arspauld/Ragnarok-2020/software/Flight Simulation/Descent Rate Equations.docx

A_c = 0.0123 m^2 , A_p =0.02 m^2 (1)

C_(D,c) =0.82, C_(D,p) =1.00 (2)

D=1/2C_D ρV^2 A (3)

V= √((2D)/(C_D ρA))=√((2mg)/(ρ(C_(D,c) A_c +C_(D,p) A_p ))) (4)

V= √((2*0.6 (kg)*9.805 (m/(s^2)))/(1.1117 ((kg)/(m^3))*(0.82*0.0123 (m^2 )+1.00*0.02 (m^2 ))))=18.76 m/s

A_c = 0.0123 m^2 , A_p =0.02 m^2 (1)

C_(D,c) =0.82, C_(D,p) =1.00 (2)

D=1/2C_D ρV^2 A (3)

V= √((2D)/(C_D ρA))=√((2mg)/(ρ(C_(D,c) A_c +C_(D,p) A_p ))) (4)

V= √((2*0.15 (kg)*9.805 (m/(s^2)))/(1.1117 ((kg)/(m^3))*(0.82*0.0123 (m^2 )+1.00*0.02 (m^2 ))))= 9.38 m/s

A_p =0.10 m^2 (1)

C_(D,p) =1.00 (2)

D=1/2C_D ρV^2 A (3)

V=√((2mg)/(C_(D,p) ρA_p)) (4)

V= √((2*0.45 (kg)*9.805 (m/(s^2)))/(1.00*1.1117 ((kg)/(m^3))*0.10 (m^2 )))=8.91 m/s

L=1/2C_L ρV^2 S (1)

C_L = (2L)/(ρV^2 S)= (2mg)/(ρV^2 S) (2)

C_D =C_(D,0) +(C_L^2)/(πeAR) (3)

V_z =-(‖V‖)/(√(((C_L)/(C_D))^2 +1)) (4)
