arspauld/Ragnarok-2020/software/Flight Simulation/glide.png

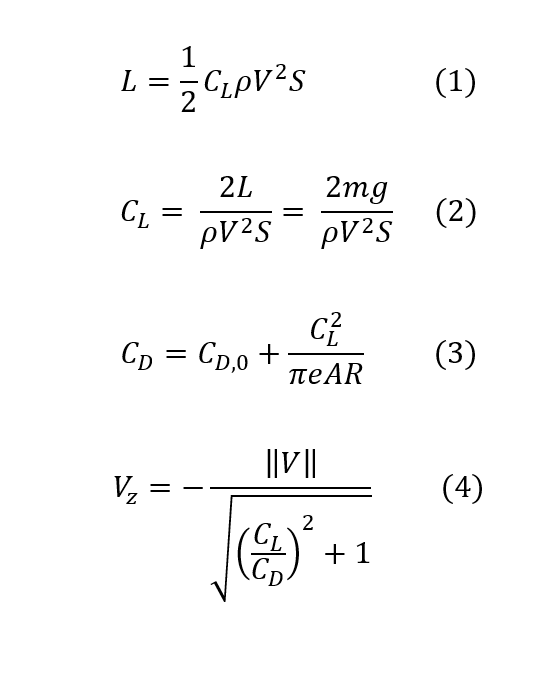
software/Flight Simulation/glide.png
