arspauld/Ragnarok-2020/software/Flight Simulation/glider.png

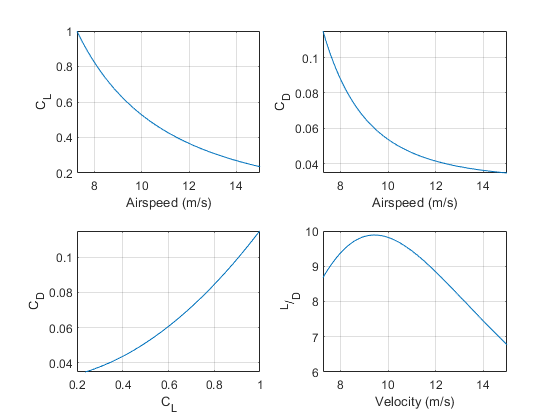
software/Flight Simulation/glider.png
