arspauld/Ragnarok-2020/software/Flight Simulation/postglide.png

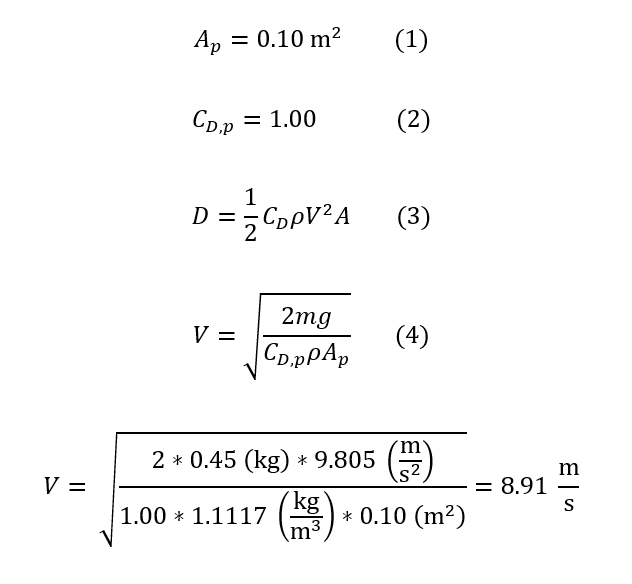
software/Flight Simulation/postglide.png
