arspauld/Ragnarok-2020/software/Flight Simulation/postrelease.png

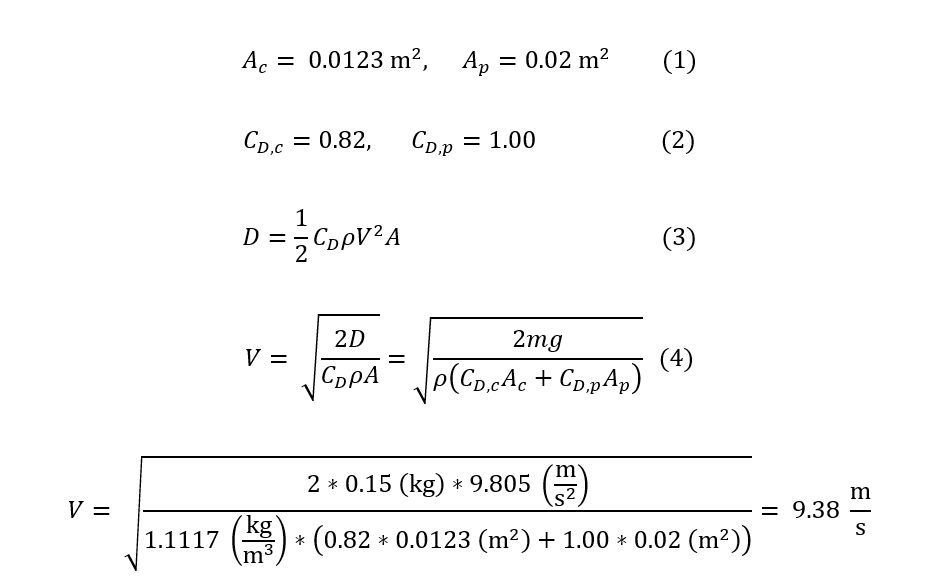
software/Flight Simulation/postrelease.png
