arspauld/Ragnarok-2020/software/Flight Simulation/prerelease.png

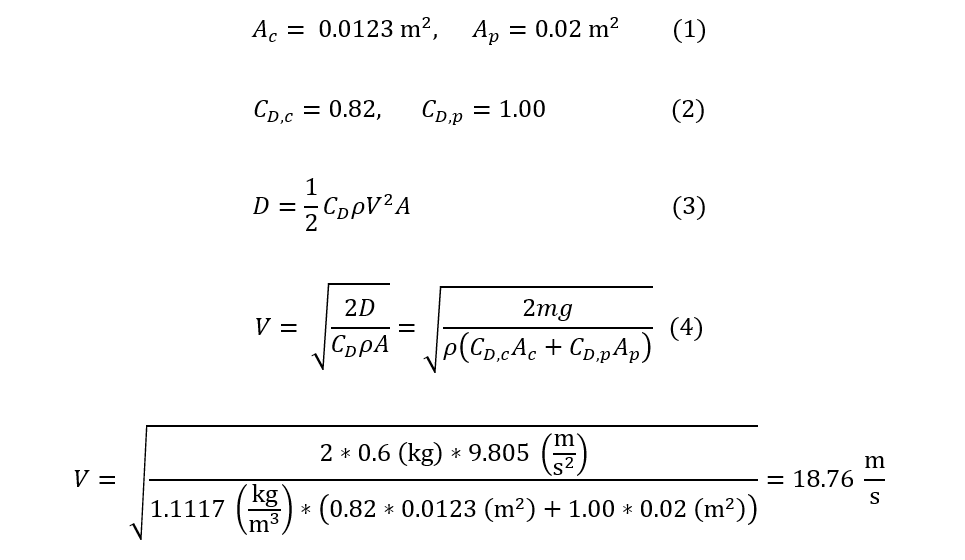
software/Flight Simulation/prerelease.png
