arspauld/Ragnarok-2020/software/Flight Simulation/sink.png

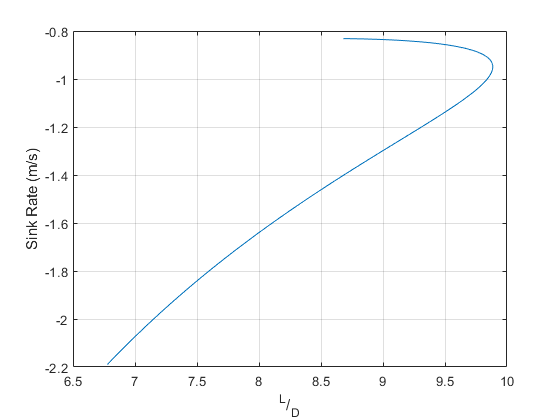
software/Flight Simulation/sink.png
