arspauld/Ragnarok-2020/(list of files, drawings)

Other design files:
hardware/documentation/STM32F4 Nucleo Layout/Connectors.SchDoc
hardware/documentation/STM32F4 Nucleo Layout/MB1136.PcbDoc
hardware/documentation/STM32F4 Nucleo Layout/MB1136.PrjPCB
hardware/documentation/STM32F4 Nucleo Layout/MB1136.SchDoc
hardware/documentation/STM32F4 Nucleo Layout/MB1136.SCHLIB
hardware/documentation/STM32F4 Nucleo Layout/MCU_64.SchDoc
hardware/documentation/STM32F4 Nucleo Layout/ST_LINK_V2-1.SCHDOC
