arspauld/Ragnarok-2020/hardware/PCBs/Ragnarok_dev/Ragnarok_dev.kicad_pcb

## KiCad design hardware/PCBs/Ragnarok_dev/Ragnarok_dev.kicad_pcb (2020-03-13)

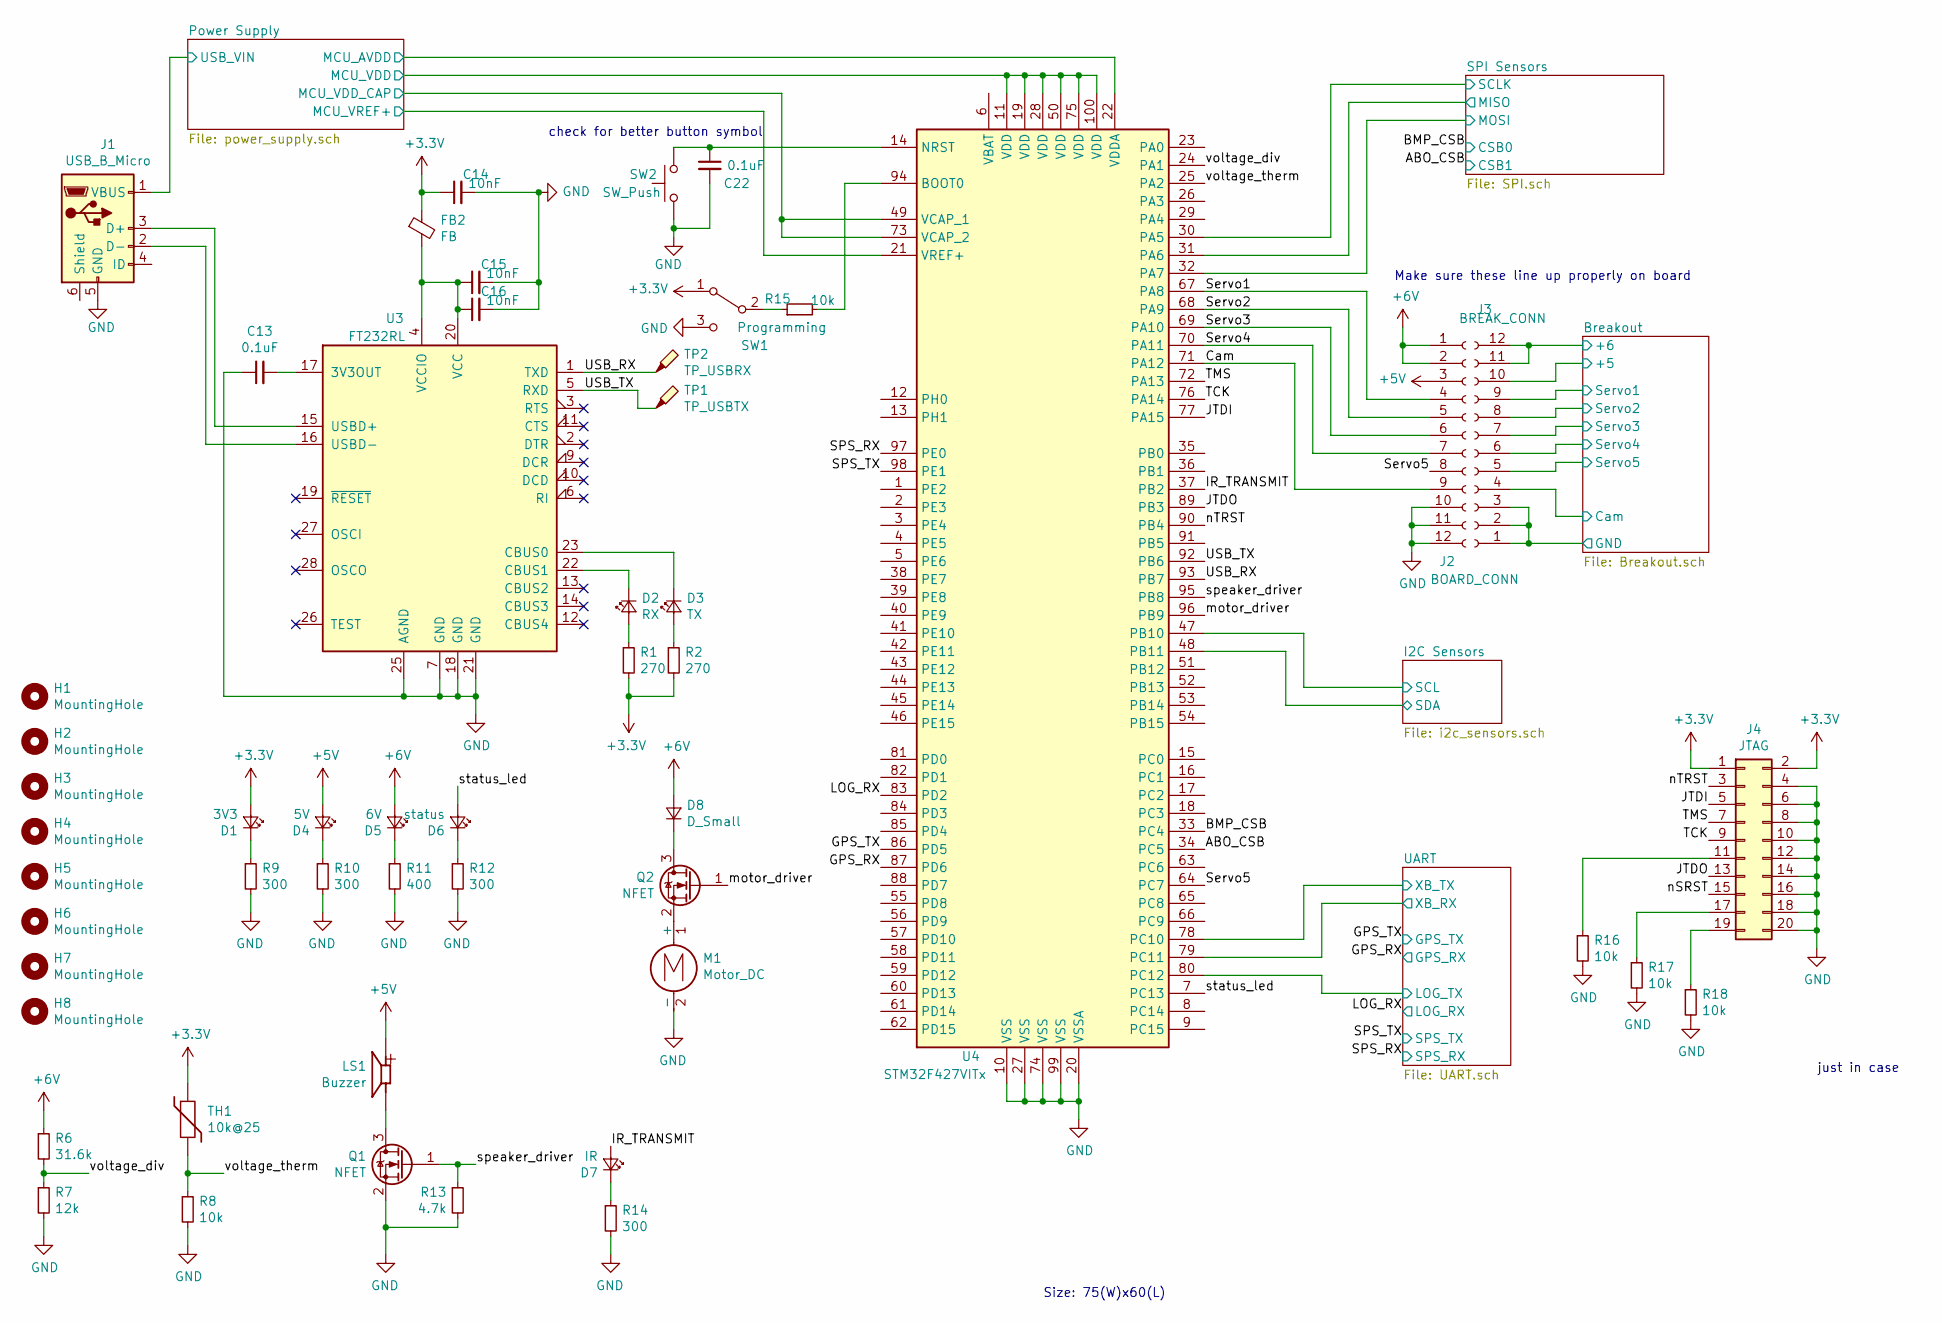
[picture p7: schematic Ragnarok_dev.sch, Ragnarok Development Board]

Parts:
C13, C22: 0.1uF; C_0603_1608Metric_Pad1.05x0.95mm_HandSolder
C14, C15, C16: 10nF; C_0603_1608Metric_Pad1.05x0.95mm_HandSolder
D1: 3V3; LED_0603_1608Metric_Pad1.05x0.95mm_HandSolder
D2: RX; LED_0603_1608Metric_Pad1.05x0.95mm_HandSolder
D3: TX; LED_0603_1608Metric_Pad1.05x0.95mm_HandSolder
D4: 5V; LED_0603_1608Metric_Pad1.05x0.95mm_HandSolder
D5: 6V; LED_0603_1608Metric_Pad1.05x0.95mm_HandSolder
D6: status; LED_0603_1608Metric_Pad1.05x0.95mm_HandSolder
D7: IR; JST_GH_SM02B-GHS-TB_1x02-1MP_P1.25mm_Horizontal
D8: D_Small; D_0603_1608Metric_Pad1.05x0.95mm_HandSolder
FB2: FB; L_0603_1608Metric_Pad1.05x0.95mm_HandSolder
H1, H2, H3, H4, H5, H6, H7, H8: MountingHole; MountingHole_2.2mm_M2
J1: USB_B_Micro; USB_Micro-B_Amphenol_10103594-0001LF_Horizontal
J2: BOARD_CONN; Board_Jumper
J3: BREAK_CONN; Board_Jumper
J4: JTAG; PinSocket_2x10_P2.00mm_Vertical
LS1: Buzzer; CUI_CMT-8540S-SMT
M1: Motor_DC; JST_GH_SM02B-GHS-TB_1x02-1MP_P1.25mm_Horizontal
Q1, Q2: NFET; SOT-23_Handsoldering
R1, R2: 270; R_0603_1608Metric_Pad1.05x0.95mm_HandSolder
R6: 31.6k; R_0603_1608Metric_Pad1.05x0.95mm_HandSolder
R7: 12k; R_0603_1608Metric_Pad1.05x0.95mm_HandSolder
R8, R15, R16, R17, R18: 10k; R_0603_1608Metric_Pad1.05x0.95mm_HandSolder
R9, R10, R12, R14: 300; R_0603_1608Metric_Pad1.05x0.95mm_HandSolder
R11: 400; R_0603_1608Metric_Pad1.05x0.95mm_HandSolder
R13: 4.7k; R_0603_1608Metric_Pad1.05x0.95mm_HandSolder
SW1: Programming; CS12ANW03
SW2: SW_Push; SW_SPST_B3SL-1022P
TH1: 10k@25; JST_GH_SM02B-GHS-TB_1x02-1MP_P1.25mm_Horizontal
TP1: TP_USBTX; TestPoint_Pad_1.0x1.0mm
TP2: TP_USBRX; TestPoint_Pad_1.0x1.0mm
U3: FT232RL; SSOP-28_5.3x10.2mm_P0.65mm
U4: STM32F427VITx; LQFP-100_14x14mm_P0.5mm

Connections:
+3V3: C14.1, D1.2 (A), FB2.1, J4.1, J4.2, R1.2, R2.2, SW1.1 (A), TH1.1, U4.11 (VDD), U4.19 (VDD), U4.21 (VREF+), U4.28 (VDD), U4.49 (VCAP_1), U4.50 (VDD), U4.73 (VCAP_2), U4.75 (VDD), U4.100 (VDD); also elsewhere on the board
+5V: D4.2 (A), J2.3, LS1.P; also elsewhere on the board
+6V: D5.2 (A), D8.2 (A), J2.1, J2.2, R6.1; also elsewhere on the board
/ABO_CSB: U4.34 (PC5); also elsewhere on the board
/BMP_CSB: U4.33 (PC4); also elsewhere on the board
/Breakout/+5: J3.10; also elsewhere on the board
/Breakout/+6: J3.11, J3.12; also elsewhere on the board
/Breakout/Cam: J3.4; also elsewhere on the board
/Breakout/Servo1: J3.9; also elsewhere on the board
/Breakout/Servo2: J3.8; also elsewhere on the board
/Breakout/Servo3: J3.7; also elsewhere on the board
/Breakout/Servo4: J3.6; also elsewhere on the board
/Breakout/Servo5: J3.5; also elsewhere on the board
/Cam: J2.9, U4.71 (PA12)
/GPS_RX: U4.87 (PD6); also elsewhere on the board
/GPS_TX: U4.86 (PD5); also elsewhere on the board
/I2C Sensors/SCL: U4.47 (PB10); also elsewhere on the board
/I2C Sensors/SDA: U4.48 (PB11); also elsewhere on the board
/IR_TRANSMIT: D7.2 (A), U4.37 (PB2)
/JTDI: J4.5, U4.77 (PA15)
/JTDO: J4.13, U4.89 (PB3)
/LOG_RX: U4.83 (PD2); also elsewhere on the board
/Power Supply/MCU_AVDD: U4.22 (VDDA); also elsewhere on the board
/Power Supply/USB_VIN: J1.1 (VBUS); also elsewhere on the board
/SPI Sensors/MISO: U4.31 (PA6); also elsewhere on the board
/SPI Sensors/MOSI: U4.32 (PA7); also elsewhere on the board
/SPI Sensors/SCLK: U4.30 (PA5); also elsewhere on the board
/SPS_RX: U4.97 (PE0); also elsewhere on the board
/SPS_TX: U4.98 (PE1); also elsewhere on the board
/Servo1: J2.4, U4.67 (PA8)
/Servo2: J2.5, U4.68 (PA9)
/Servo3: J2.6, U4.69 (PA10)
/Servo4: J2.7, U4.70 (PA11)
/Servo5: J2.8, U4.64 (PC7)
/TCK: J4.9, U4.76 (PA14)
/TMS: J4.7, U4.72 (PA13)
/UART/LOG_TX: U4.80 (PC12); also elsewhere on the board
/UART/XB_RX: U4.79 (PC11); also elsewhere on the board
/UART/XB_TX: U4.78 (PC10); also elsewhere on the board
/USB_RX: TP2.1, U3.1 (TXD), U4.93 (PB7)
/USB_TX: TP1.1, U3.5 (RXD), U4.92 (PB6)
/motor_driver: Q2.1 (G), U4.96 (PB9)
/nSRST: J4.15
/nTRST: J4.3, U4.90 (PB4)
/speaker_driver: Q1.1 (G), R13.1, U4.95 (PB8)
/status_led: D6.2 (A), U4.7 (PC13)
/voltage_div: R6.2, R7.1, U4.24 (PA1)
/voltage_therm: R8.1, TH1.2, U4.25 (PA2)
GND: C13.1, C14.2, C15.2, C16.2, C22.2, J1.5 (GND), J2.10, J2.11, J2.12, J3.1, J3.2, J3.3, J4.4, J4.6, J4.8, J4.10, J4.12, J4.14, J4.16, J4.18, J4.20, M1.2 (-), Q1.2 (S), R7.2, R8.2, R9.2, R10.2, R11.2, R12.2, R13.2, R14.2, R16.2, R17.2, R18.2, SW1.3 (C), SW2.2, U3.7 (GND), U3.18 (GND), U3.21 (GND), U3.25 (AGND), U4.10 (VSS), U4.20 (VSSA), U4.27 (VSS), U4.74 (VSS), U4.99 (VSS); also elsewhere on the board
unnamed: C13.2, U3.17 (3V3OUT)
unnamed: C15.1, C16.1, FB2.2, U3.4 (VCCIO), U3.20 (VCC)
unnamed: C22.1, SW2.1, U4.14 (NRST)
unnamed: D1.1 (K), R9.1
unnamed: D2.1 (K), U3.22 (CBUS1)
unnamed: D2.2 (A), R1.1
unnamed: D3.1 (K), U3.23 (CBUS0)
unnamed: D3.2 (A), R2.1
unnamed: D4.1 (K), R10.1
unnamed: D5.1 (K), R11.1
unnamed: D6.1 (K), R12.1
unnamed: D7.1 (K), R14.1
unnamed: D8.1 (K), Q2.3 (D)
unnamed: J1.2 (D-), U3.16 (USBD-)
unnamed: J1.3 (D+), U3.15 (USBD+)
unnamed: J4.11, R16.1
unnamed: J4.17, R17.1
unnamed: J4.19, R18.1
unnamed: LS1.N, Q1.3 (D)
unnamed: M1.1 (+), Q2.2 (S)
unnamed: R15.1, SW1.2 (B)
unnamed: R15.2, U4.94 (BOOT0)

Notes on the sheet:
Make sure these line up properly on board
check for better button symbol
just in case
Size: 75(W)x60(L)

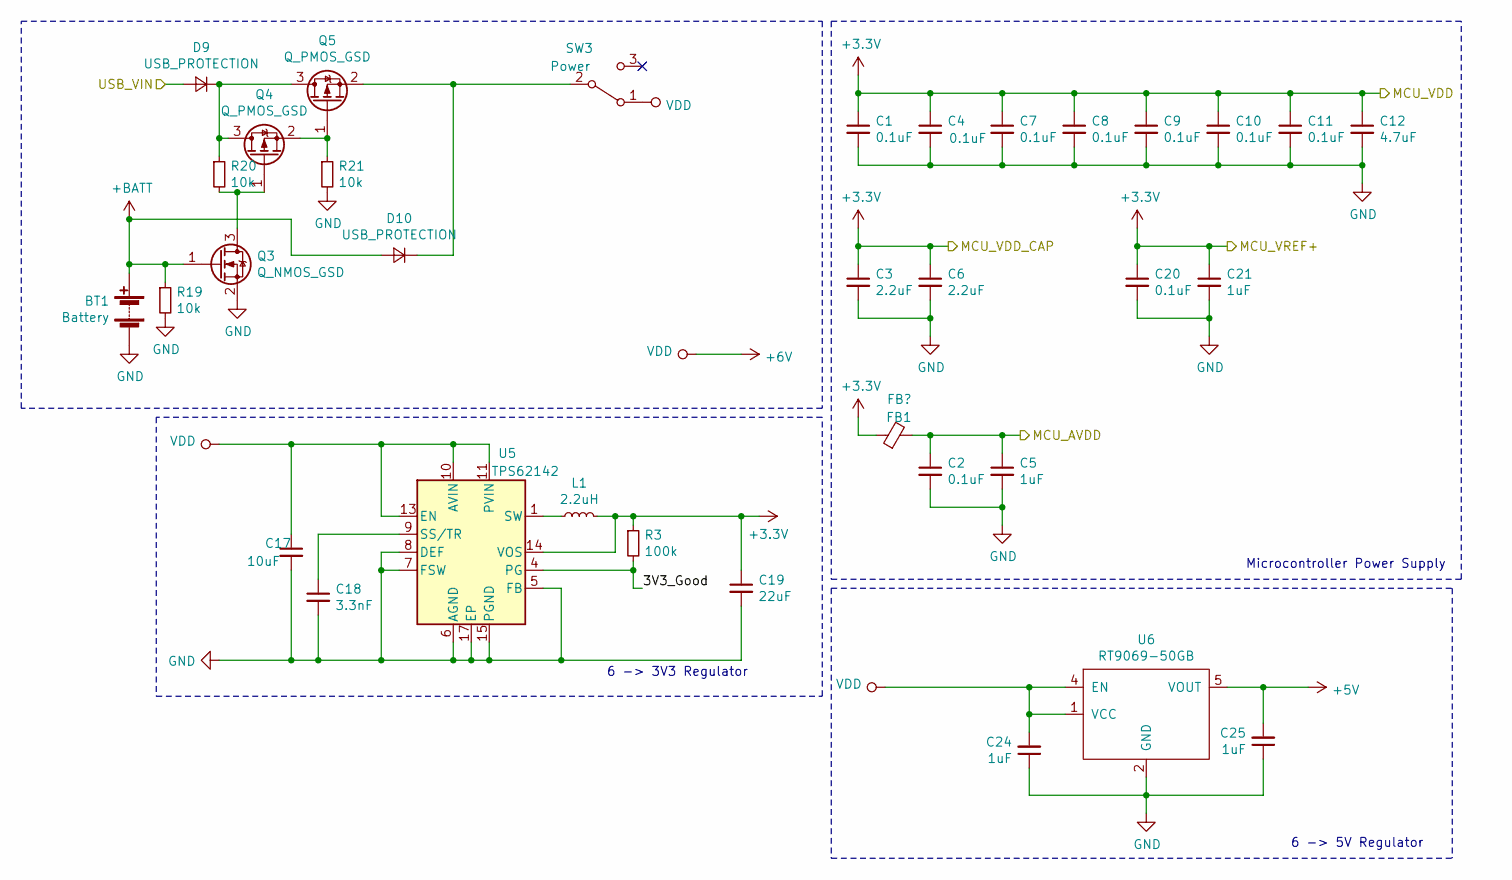
[picture p8: schematic power_supply.sch, Ragnarok Development Board]

Parts:
BT1: Battery; JST_GH_SM02B-GHS-TB_1x02-1MP_P1.25mm_Horizontal
C1, C2, C4, C7, C8, C9, C10, C11, C20: 0.1uF; C_0603_1608Metric_Pad1.05x0.95mm_HandSolder
C3, C6: 2.2uF; C_0603_1608Metric_Pad1.05x0.95mm_HandSolder
C5, C21, C24, C25: 1uF; C_0603_1608Metric_Pad1.05x0.95mm_HandSolder
C12: 4.7uF; C_0603_1608Metric_Pad1.05x0.95mm_HandSolder
C17: 10uF; C_0603_1608Metric_Pad1.05x0.95mm_HandSolder
C18: 3.3nF; C_0603_1608Metric_Pad1.05x0.95mm_HandSolder
C19: 22uF; C_0603_1608Metric_Pad1.05x0.95mm_HandSolder
D9, D10: USB_PROTECTION; D_0603_1608Metric_Pad1.05x0.95mm_HandSolder
FB1: FB?; L_0603_1608Metric_Pad1.05x0.95mm_HandSolder
L1: 2.2uH; L_0603_1608Metric_Pad1.05x0.95mm_HandSolder
Q3: Q_NMOS_GSD; SOT-23_Handsoldering
Q4, Q5: Q_PMOS_GSD; SOT-23_Handsoldering
R3: 100k; R_0603_1608Metric_Pad1.05x0.95mm_HandSolder
R19, R20, R21: 10k; R_0603_1608Metric_Pad1.05x0.95mm_HandSolder
SW3: Power; CS12ANW03
U5: TPS62142; QFN-16-1EP_3x3mm_P0.5mm_EP1.8x1.8mm
U6: RT9069-50GB; SOT-23-5

Connections:
+3V3: C1.1, C3.1, C4.1, C6.1, C7.1, C8.1, C9.1, C10.1, C11.1, C12.1, C19.1, C20.1, C21.1, FB1.1, L1.2, R3.1, U5.14 (VOS); also elsewhere on the board
+5V: C25.2, U6.5 (VOUT); also elsewhere on the board
+6V: C17.1, C24.2, SW3.1 (A), U5.10 (AVIN), U5.11 (PVIN), U5.12 (PVIN), U5.13 (EN), U6.1 (VCC), U6.4 (EN); also elsewhere on the board
+BATT: BT1.1 (+), D10.2 (A), Q3.1 (G), R19.1
/Power Supply/3V3_Good: R3.2, U5.4 (PG)
/Power Supply/MCU_AVDD: C2.1, C5.1, FB1.2; also elsewhere on the board
/Power Supply/USB_VIN: D9.2 (A); also elsewhere on the board
GND: BT1.2 (-), C1.2, C2.2, C3.2, C4.2, C5.2, C6.2, C7.2, C8.2, C9.2, C10.2, C11.2, C12.2, C17.2, C18.2, C19.2, C20.2, C21.2, C24.1, C25.1, Q3.2 (S), R19.2, R21.2, U5.5 (FB), U5.6 (AGND), U5.7 (FSW), U5.8 (DEF), U5.15 (PGND), U5.16 (PGND), U5.17 (EP), U6.2 (GND); also elsewhere on the board
unnamed: C18.1, U5.9 (SS/TR)
unnamed: D9.1 (K), Q4.3 (D), Q5.3 (D), R20.1
unnamed: D10.1 (K), Q5.2 (S), SW3.2 (B)
unnamed: L1.1, U5.1 (SW), U5.2 (SW), U5.3 (SW)
unnamed: Q3.3 (D), Q4.1 (G), R20.2
unnamed: Q4.2 (S), Q5.1 (G), R21.1

Notes on the sheet:
Microcontroller Power Supply
6 -> 3V3 Regulator
6 -> 5V Regulator

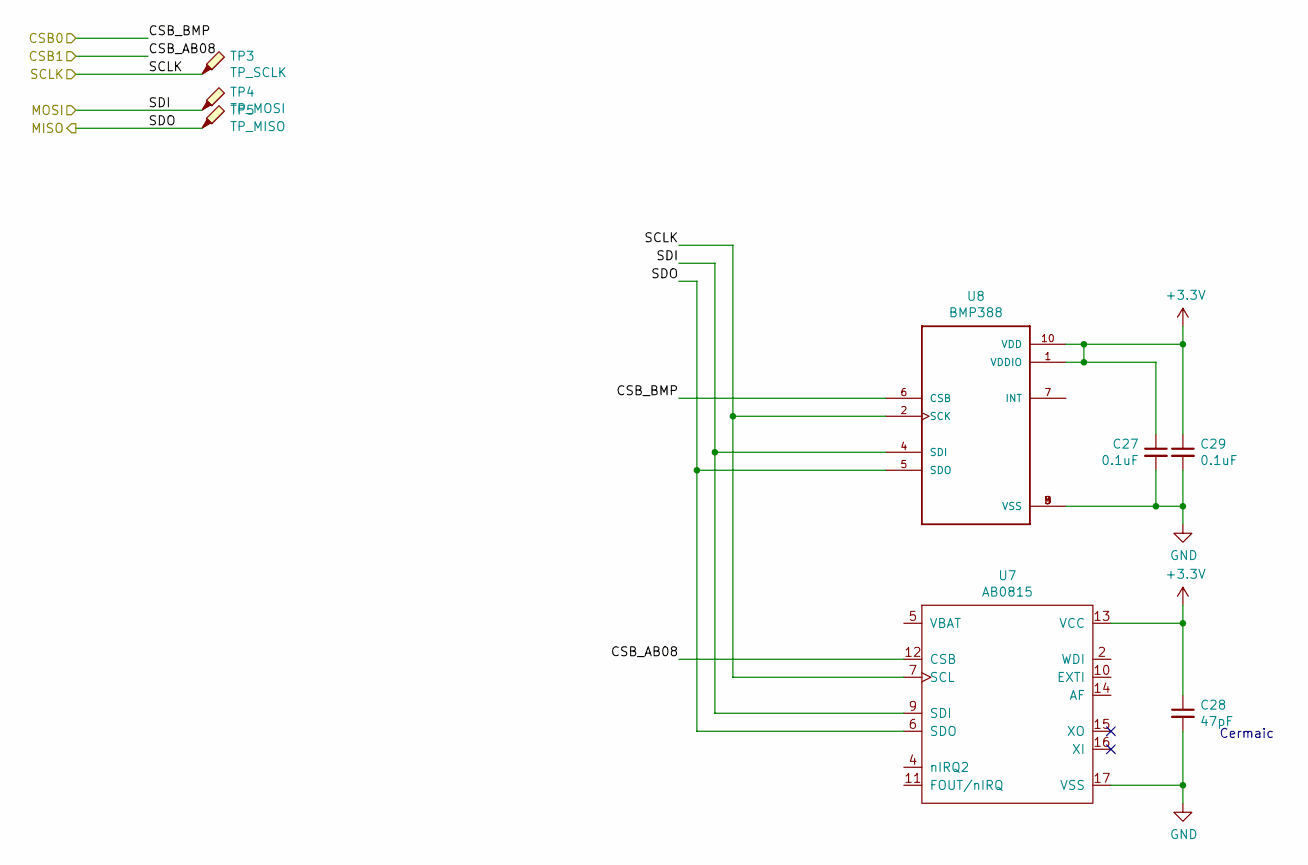
[picture p9: schematic SPI.sch]

Parts:
C27, C29: 0.1uF; C_0603_1608Metric_Pad1.05x0.95mm_HandSolder
C28: 47pF; C_0603_1608Metric_Pad1.05x0.95mm_HandSolder
TP3: TP_SCLK; TestPoint_Pad_1.0x1.0mm
TP4: TP_MOSI; TestPoint_Pad_1.0x1.0mm
TP5: TP_MISO; TestPoint_Pad_1.0x1.0mm
U7: AB0815; QFN-16-1EP_5x5mm_P0.8mm_EP2.7x2.7mm
U8: BMP388; PQFN50P200X200X80-10N

Connections:
+3V3: C27.1, C28.1, C29.1, U7.13 (VCC), U8.1 (VDDIO), U8.10 (VDD); also elsewhere on the board
/ABO_CSB: U7.12 (CSB); also elsewhere on the board
/BMP_CSB: U8.6 (CSB); also elsewhere on the board
/SPI Sensors/MISO: TP5.1, U7.6 (SDO), U8.5 (SDO); also elsewhere on the board
/SPI Sensors/MOSI: TP4.1, U7.9 (SDI), U8.4 (SDI); also elsewhere on the board
/SPI Sensors/SCLK: TP3.1, U7.7 (SCL), U8.2 (SCK); also elsewhere on the board
GND: C27.2, C28.2, C29.2, U7.17 (VSS), U8.3 (VSS), U8.8 (VSS), U8.9 (VSS); also elsewhere on the board

Notes on the sheet:
Cermaic

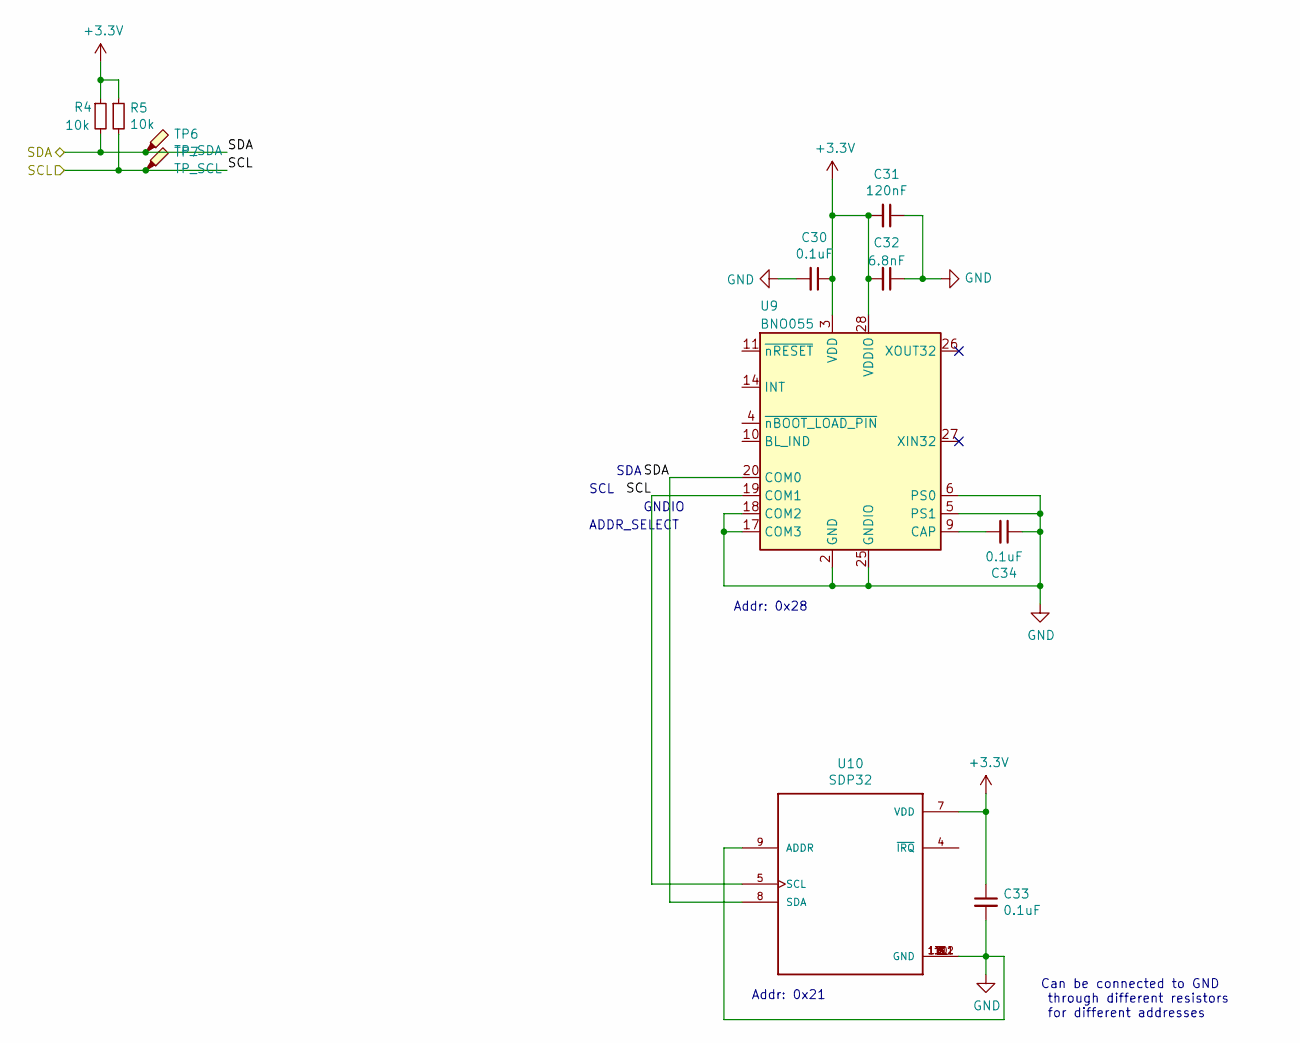
[picture p10: schematic i2c_sensors.sch]

Parts:
C30, C33, C34: 0.1uF; C_0603_1608Metric_Pad1.05x0.95mm_HandSolder
C31: 120nF; C_0603_1608Metric_Pad1.05x0.95mm_HandSolder
C32: 6.8nF; C_0603_1608Metric_Pad1.05x0.95mm_HandSolder
R4, R5: 10k; R_0603_1608Metric_Pad1.05x0.95mm_HandSolder
TP6: TP_SDA; TestPoint_Pad_1.0x1.0mm
TP7: TP_SCL; TestPoint_Pad_1.0x1.0mm
U9: BNO055; LGA-28_5.2x3.8mm_P0.5mm
U10: SDP32; XDCR_SDP32-125PA-TR-250PCS

Connections:
+3V3: C30.1, C31.2, C32.2, C33.1, R4.1, R5.1, U9.3 (VDD), U9.28 (VDDIO), U10.7 (VDD); also elsewhere on the board
/I2C Sensors/SCL: R5.2, TP7.1, U9.19 (COM1), U10.5 (SCL); also elsewhere on the board
/I2C Sensors/SDA: R4.2, TP6.1, U9.20 (COM0), U10.8 (SDA); also elsewhere on the board
GND: C30.2, C31.1, C32.1, C33.2, C34.1, U9.2 (GND), U9.5 (PS1), U9.6 (PS0), U9.15 (GNDIO), U9.16 (GNDIO), U9.17 (COM3), U9.18 (COM2), U9.25 (GNDIO), U10.1 (GND), U10.2 (GND), U10.3 (GND), U10.6 (GND), U10.9 (ADDR), U10.10 (GND), U10.11 (GND), U10.17_1 (GND), U10.17_2 (GND); also elsewhere on the board
unnamed: C34.2, U9.9 (CAP)

Notes on the sheet:
Can be connected to GND through different resistors for different addresses
SDA
SCL
ADDR_SELECT
GNDIO
Addr: 0x28
Addr: 0x21

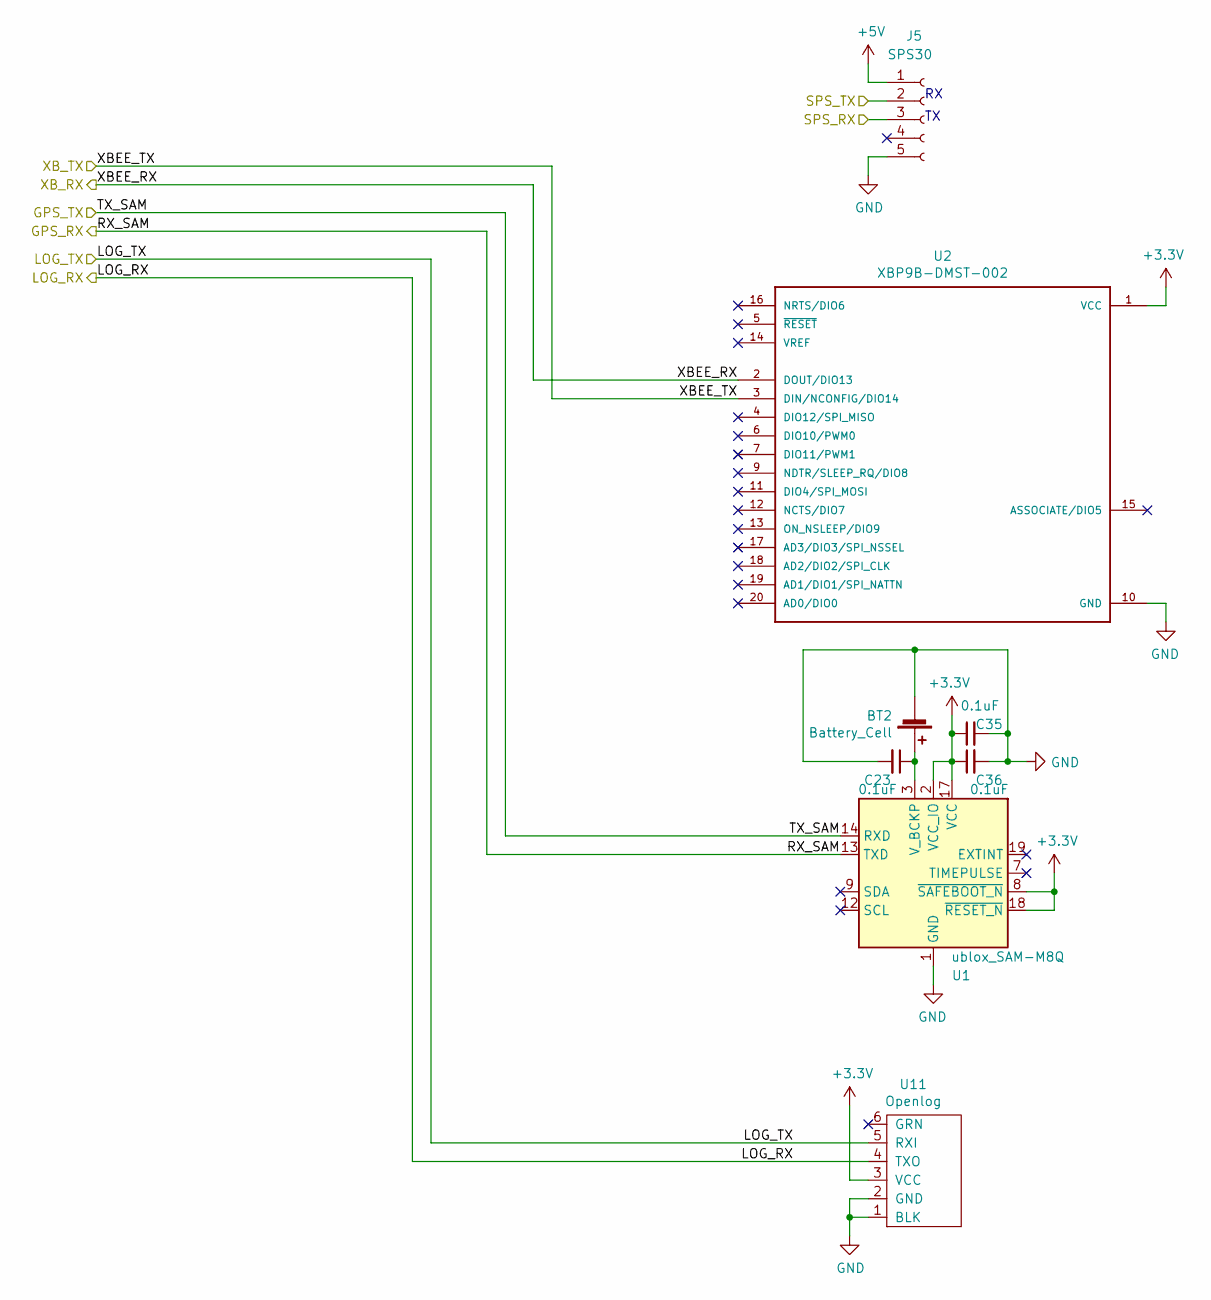
[picture p11: schematic UART.sch]

Parts:
BT2: Battery_Cell
C23, C35, C36: 0.1uF; C_0603_1608Metric_Pad1.05x0.95mm_HandSolder
J5: SPS30; JST_GH_SM05B-GHS-TB_1x05-1MP_P1.25mm_Horizontal
U1: ublox_SAM-M8Q; ublox_SAM-M8Q_HandSolder
U2: XBP9B-DMST-002; DIP2200W51P200L3294H279Q20P
U11: Openlog; PinHeader_1x06_P2.54mm_Vertical

Connections:
+3V3: C35.1, C36.1, U1.2 (VCC_IO), U1.8 (~SAFEBOOT_N), U1.17 (VCC), U1.18 (~RESET_N), U2.1 (VCC), U11.3 (VCC); also elsewhere on the board
+5V: J5.1; also elsewhere on the board
/GPS_RX: U1.13 (TXD); also elsewhere on the board
/GPS_TX: U1.14 (RXD); also elsewhere on the board
/LOG_RX: U11.4 (TXO); also elsewhere on the board
/SPS_RX: J5.3; also elsewhere on the board
/SPS_TX: J5.2; also elsewhere on the board
/UART/LOG_TX: U11.5 (RXI); also elsewhere on the board
/UART/XB_RX: U2.2 (DOUT/DIO13); also elsewhere on the board
/UART/XB_TX: U2.3 (DIN/NCONFIG/DIO14); also elsewhere on the board
GND: BT2.2 (-), C23.2, C35.2, C36.2, J5.5, U1.1 (GND), U1.4 (GND), U1.5 (GND), U1.6 (GND), U1.10 (GND), U1.11 (GND), U1.15 (GND), U1.16 (GND), U1.20 (GND), U2.10 (GND), U11.1 (BLK), U11.2 (GND); also elsewhere on the board
unnamed: BT2.1 (+), C23.1, U1.3 (V_BCKP)

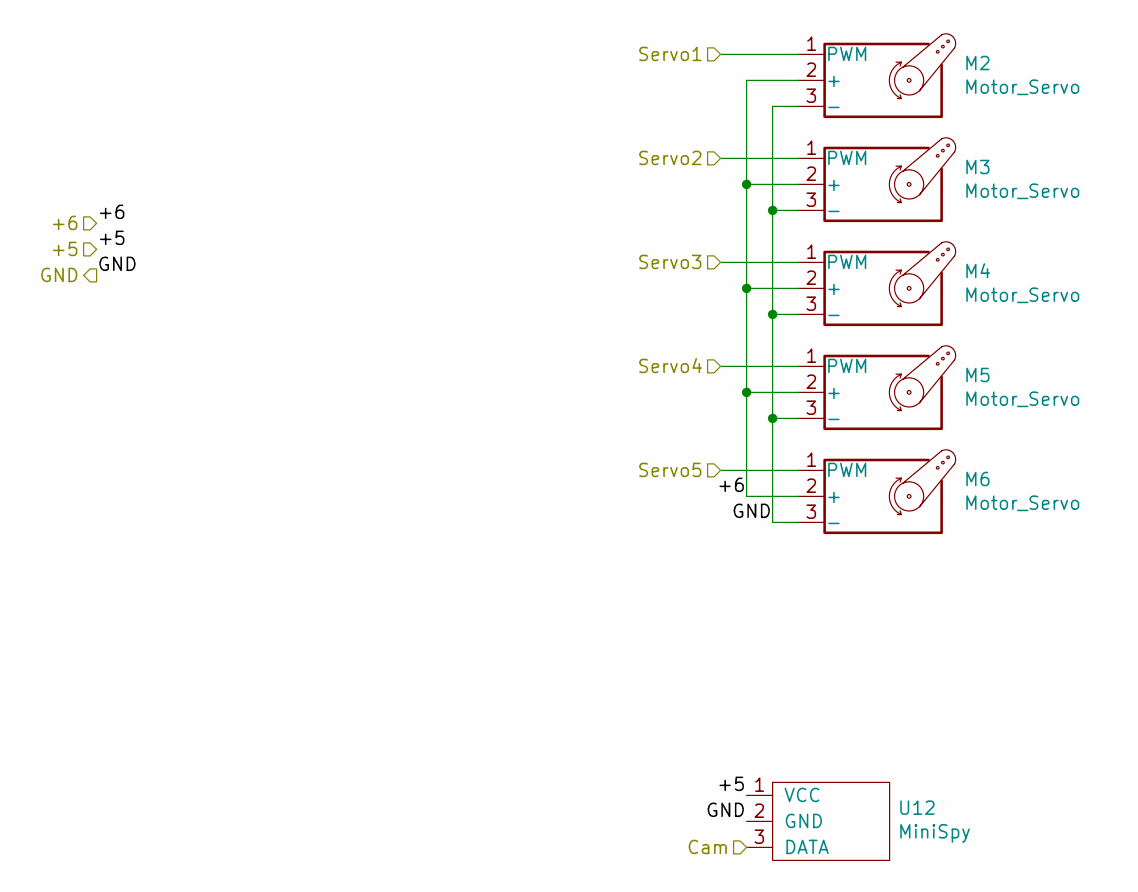
[picture p12: schematic Breakout.sch]

Parts:
M2, M3, M4, M5, M6: Motor_Servo; JST_GH_SM03B-GHS-TB_1x03-1MP_P1.25mm_Horizontal
U12: MiniSpy; JST_GH_SM03B-GHS-TB_1x03-1MP_P1.25mm_Horizontal

Connections:
/Breakout/+5: U12.1 (VCC); also elsewhere on the board
/Breakout/+6: M2.2 (+), M3.2 (+), M4.2 (+), M5.2 (+), M6.2 (+); also elsewhere on the board
/Breakout/Cam: U12.3 (DATA); also elsewhere on the board
/Breakout/Servo1: M2.1 (PWM); also elsewhere on the board
/Breakout/Servo2: M3.1 (PWM); also elsewhere on the board
/Breakout/Servo3: M4.1 (PWM); also elsewhere on the board
/Breakout/Servo4: M5.1 (PWM); also elsewhere on the board
/Breakout/Servo5: M6.1 (PWM); also elsewhere on the board
GND: M2.3 (-), M3.3 (-), M4.3 (-), M5.3 (-), M6.3 (-), U12.2 (GND); also elsewhere on the board

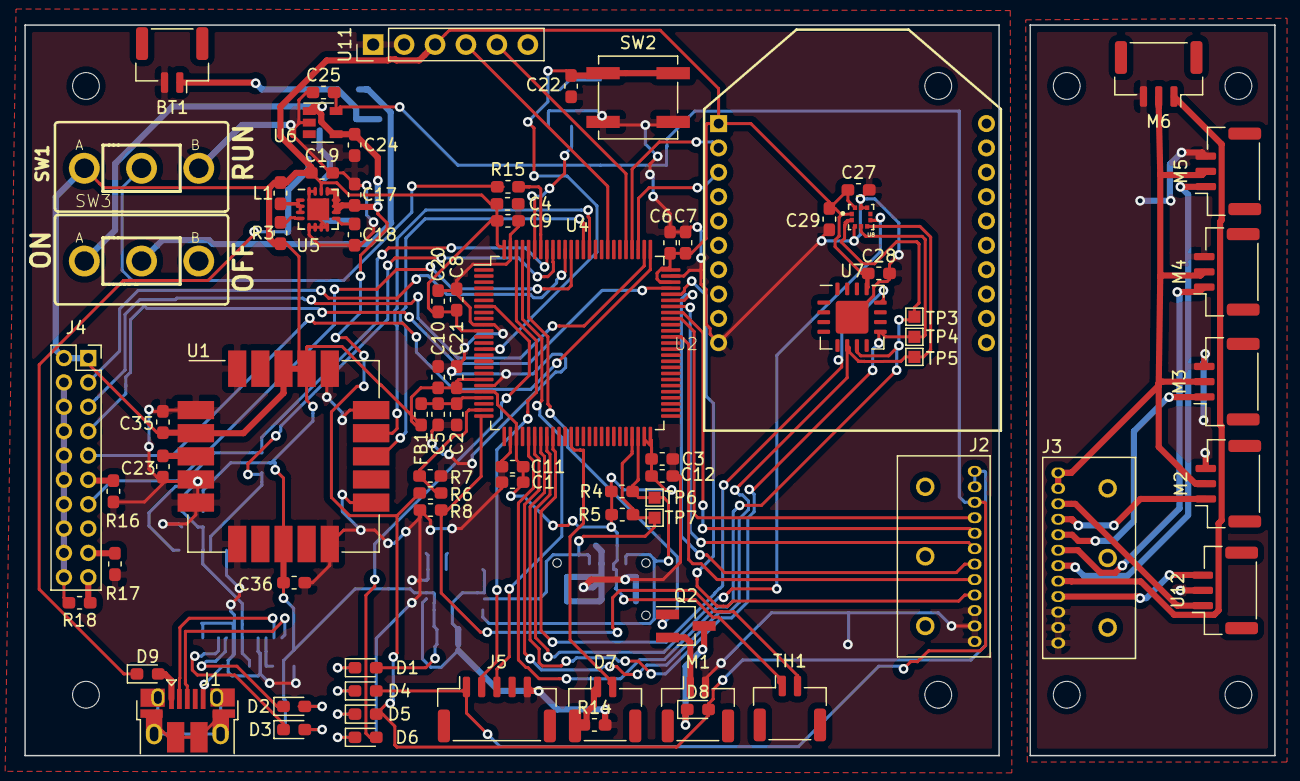
[picture p13: board Ragnarok_dev.kicad_pcb from above]

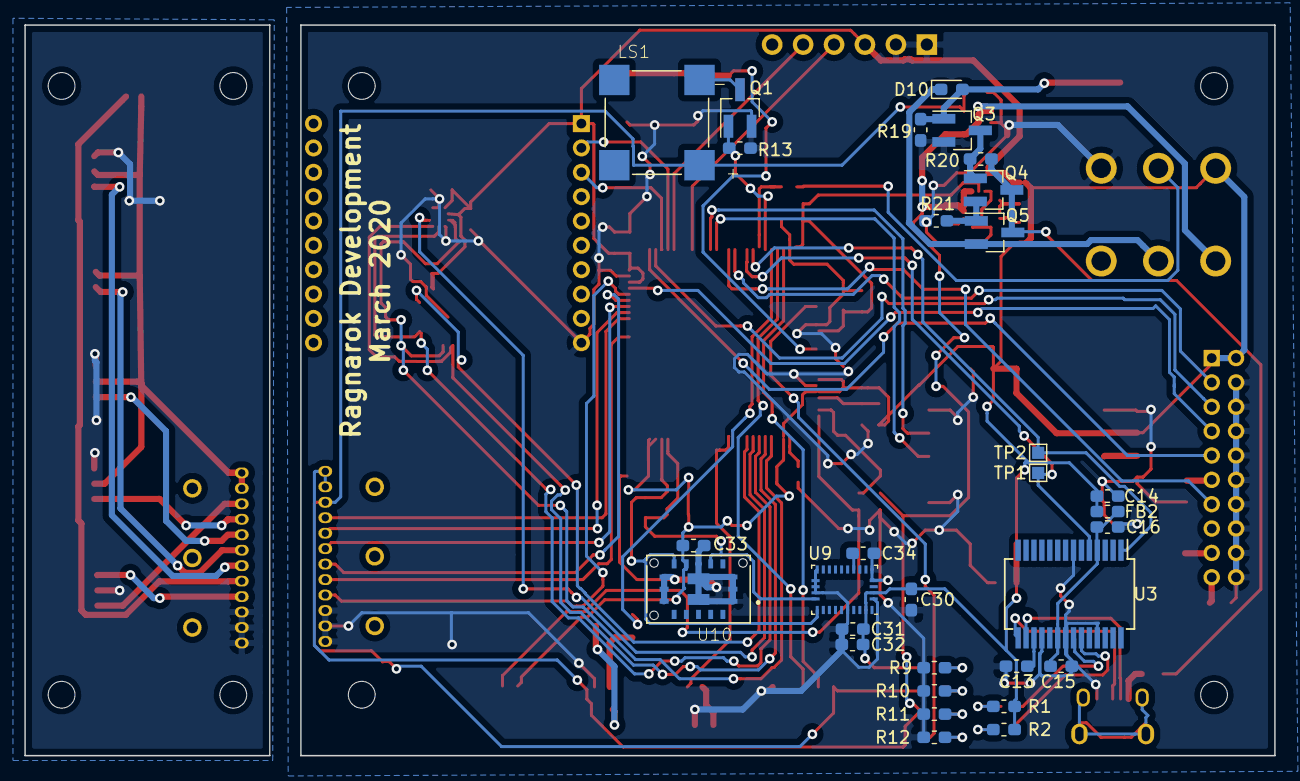
[picture p14: board Ragnarok_dev.kicad_pcb from below]

Board: 2 copper layers, 102.7 x 60.0 mm, 118 parts (31 on the bottom side), 80 nets.
