arspauld/Ragnarok-2020/software/payload/Test/src/USART.c

#include "USART.h"
#include <string.h>

/* TO-DO
 * - Implement USART1 and USART6
 * - Implement a way to select pins for USART (USART1 has 3 possible RXs and TXs each)
 * - Error Handling
 */

void usart_init(USART_options_t* options)
{
    USART_TypeDef*  USARTx  =   options->port; // USART port name
    uint32_t        baud    =   options->baud; // USART baud rate value
    uint8_t         clock   =   options->clock; // Boolean of if the clock is to be on (USART vs. UART)
    uint8_t         ints    =   options->interrupts; // Interrupt options
    uint8_t         dir     =   options->direction; // Direction Options
    uint8_t         ovrsmp  =   options->oversampling; // Oversampling Selection
    uint8_t         tx      =   options->tx_pin;
    uint8_t         rx      =   options->rx_pin;
    uint8_t         clk     =   options->clk_pin;

    if(IS_UART_INSTANCE(USARTx))
    {
        if(USARTx == USART2)
        {
            enable_peripheral(USART2_EN); // Enables USART2

            if(is_USART_TX(USARTx, tx)) set_GPIO_pin_mode(tx, GPIO_ALT_FUNC);
            if(is_USART_RX(USARTx, rx)) set_GPIO_pin_mode(rx, GPIO_ALT_FUNC);

            GPIOA->OSPEEDR |= (0b11 << (GPIO_PIN_3_Pos * 2)) | (0b11 << (GPIO_PIN_2_Pos * 2)); // Sets pins 2 and 3 to high speed
            GPIOA->AFR[0] |= (AF7 << (GPIO_PIN_3_Pos * 4)) | (AF7 << (GPIO_PIN_2_Pos * 4)); // Enables USART2 Alternate Function for pins 2 and 3

            if(clock)
            {
                if(is_USART_CLK(USARTx, clk)) set_GPIO_pin_mode(clk, GPIO_ALT_FUNC);

                GPIOA->OSPEEDR |= (0b11 << (GPIO_PIN_4_Pos * 2)); // Sets pin 4 to high speed and alternate function 7
                GPIOA->AFR[0] |= (AF7 << (GPIO_PIN_4_Pos * 4));
            }

            if(ints) NVIC_EnableIRQ(USART2_IRQn); // Enables interrupts
        }

        USARTx->BRR |= (APB1_Clock / (ovrsmp * baud) << USART_BRR_DIV_Mantissa_Pos) | (APB1_Clock / baud) % ovrsmp; // Sets a baud rate divider of 325.5 (9600 baud)
        
        if(dir & RX_Only) USARTx->CR1 |= USART_CR1_RE; 
        if(dir & TX_Only) USARTx->CR1 |= USART_CR1_TE;
        
        if(clock) USARTx->CR2 |= USART_CR2_CLKEN; // Enables the clock signal
        
        enable_interrupt(USARTx, ints); // Enables Any Interrupts Set
        USARTx->CR1 |= USART_CR1_UE; // Enables USART
        
        while(!(USARTx->SR & USART_SR_TC)); // Clear TC Flag
    }
}

void usart_write_byte(USART_TypeDef* port, uint8_t datum)
{
    port->DR = datum; // Places byte into data register
}

uint8_t usart_read_byte(USART_TypeDef* port)
{
    return port->DR; // Retrieves byte from data register
}

void usart_write(USART_TypeDef* port, uint8_t* data)
{
    for(uint8_t i = 0; i < sizeof(data); i++)
    {
        usart_write_byte(port, data[i]); // Increments through array of unsigned bytes
        while(!(port->SR & USART_SR_TC));
    }
}

void usart_write_string(USART_TypeDef* port, char* str)
{
    for(uint8_t i = 0; i < strlen(str); i++)
    {
        usart_write_byte(port, (uint8_t) str[i]); // Increments through string
        while(!(port->SR & USART_SR_TC));
    }
}

void enable_interrupt(USART_TypeDef* port, uint8_t interrupt)
{
    if(interrupt & TXE_IF)       port->CR1 |= USART_CR1_TXEIE;     // Enalbes the Tranmission Register Empty Interrupt
    if(interrupt & CTS_IF)       port->CR3 |= USART_CR3_CTSIE;     // Enables the Clear To Send Interrupt
    if(interrupt & TC_IF)        port->CR1 |= USART_CR1_TCIE;      // Enables the Transmission Complete Interrupt
    if(interrupt & RXNE_IF)      port->CR1 |= USART_CR1_RXNEIE;    // Enables the Receiver Register Not Empty Intterupt 
    if(interrupt & IDLE_IF)      port->CR1 |= USART_CR1_IDLEIE;    // Enables the Idle Interrupt
    if(interrupt & PE_IF)        port->CR1 |= USART_CR1_PEIE;      // Enables the Parity Error Interrupt
    if(interrupt & LBD_IF)       port->CR2 |= USART_CR2_LBDIE;     // Enables the LIN Break Detected Flag Interrupt
    if(interrupt & E_IF)         port->CR3 |= USART_CR3_EIE;       // Enables the Error Interrupt
}

void disable_interrupt(USART_TypeDef* port, uint8_t interrupt)
{
    if(interrupt & TXE_IF)       port->CR1 &= ~USART_CR1_TXEIE;    // Enalbes the Tranmission Register Empty Interrupt
    if(interrupt & CTS_IF)       port->CR3 &= ~USART_CR3_CTSIE;    // Enables the Clear To Send Interrupt
    if(interrupt & TC_IF)        port->CR1 &= ~USART_CR1_TCIE;     // Enables the Transmission Complete Interrupt
    if(interrupt & RXNE_IF)      port->CR1 &= ~USART_CR1_RXNEIE;   // Enables the Receiver Register Not Empty Intterupt 
    if(interrupt & IDLE_IF)      port->CR1 &= ~USART_CR1_IDLEIE;   // Enables the Idle Interrupt
    if(interrupt & PE_IF)        port->CR1 &= ~USART_CR1_PEIE;     // Enables the Parity Error Interrupt
    if(interrupt & LBD_IF)       port->CR2 &= ~USART_CR2_LBDIE;    // Enables the LIN Break Detected Flag Interrupt
    if(interrupt & E_IF)         port->CR3 &= ~USART_CR3_EIE;      // Enables the Error Interrupt
}
