arspauld/Ragnarok-2020/(commit log)

2019-10-19 Create ina233.pdf
    Added voltage sensor documentation
2019-10-19 Add documentation
    Added pressure sensor documentation
2019-10-19 Add documentation
    added temperature sensor documentation; LM35 datasheet applies to 2 separate sensors
2019-10-19 Add documentation
    Added particulate sensor documentation
2019-10-19 Add documentation for IMUs
2019-11-11 connected over uart and entering basic commands
2019-11-13 upload script is working, need to work on interfacing with platformio and fixing verification
    [extra_script.py, main.c, upload_script.py]
2019-12-07 Bare Metal Blink?
    [Connectors.SchDoc, MB1136.PcbDoc, MB1136.PrjPCB, MB1136.SCHLIB, MB1136.SchDoc, MCU_64.SchDoc, ST_LINK_V2-1.SCHDOC]
2019-12-09 PWM on A0
2019-12-10 USART (or at least UART) works
2019-12-11 GPIO Interrupt
2019-12-11 UART Echo (unstable)
2019-12-14 I2C read?
2019-12-14 built to check for syntactical errors
    [main.c]
2019-12-18 I2C read
2019-12-19 ADC maybe works
2019-12-19 progress on power supply, USB programming
2019-12-19 ADC Tested and seems to be functional
2019-12-20 minor changes
    [Ragnarok_dev.kicad_pcb, Ragnarok_dev.sch, power_supply.sch]
2019-12-24 ground_station updates
    this is what I have so far, I have not spent too much time so bare with me
    [2019.py, groundStation.py, realplot.py]
2019-12-28 fixed RTP inheritance, testclass works for groundstation.py
    [groundStation.py, realplot.py]
2020-01-05 changed case of dock titles
2020-01-10 add spi sheet
    [Ragnarok_dev.sch, SPI.sch, power_supply.sch]
2020-01-29 replace 5v regulator
2020-02-26 much schematic work
    [Breakout.sch, Ragnarok_dev.sch, SPI.sch, UART.sch, i2c_sensors.sch, power_supply.sch]
2020-03-06 finish schematic
    [Ragnarok_dev.kicad_pcb, Ragnarok_dev.sch, UART.sch, power_supply.sch]
2020-03-07 begin layout
    [Ragnarok_dev.kicad_pcb, Ragnarok_dev.sch, power_supply.sch]
2020-03-09 first PCB
    [Ragnarok_dev.kicad_pcb, Ragnarok_dev.sch, UART.sch, i2c_sensors.sch]
2020-03-13 final changes
    [Ragnarok_dev.kicad_pcb]
